felixd/STM32-GPSDO/software/GPSDO/Sensor_BMP180.h

/*
  Sensor_BMP180.h - Library for handling BMP180 sensor
  Created by Paweł 'felixd' Wojciechowski, Janury 31, 2022.

  BMP180 is I2C atmospheric pressure, temperature and altitude sensor
*/

#ifndef GPSDO_SENSOR_BMP180_h
#define GPSDO_SENSOR_BMP180_h

#include <Arduino.h>
#include <Adafruit_BMP085.h>

/*
 * Just to quickly, be able to integrate it with Andrews GPSDO
 */
#define GPSDO_SENSOR_BMP280

#endif
