felixd/STM32-GPSDO/software/GPSDO/Sensor_AHT10.h

/*
  Sensor_AHT10.h - Library for handling AHT10 sensor
  Created by Paweł 'felixd' Wojciechowski, Janury 31, 2022.

  AHT10 is I2C temperature and humidity sensor
*/

#include "Arduino.h"
#include <Adafruit_AHTX0.h>

#ifndef GPSDO_SENSOR_AHT10_h
#define GPSDO_SENSOR_AHT10_h
#define GPSDO_SENSOR_AHT10

/*
  Sensor: AHTX0
  Sensing: temperature, humidity
  Library: Adafruit_AHTX0
*/

#endif
