felixd/STM32-GPSDO/software/GPSDO/Sensor_INA219.cpp

/*
  Sensor_INA219.h - Library for handling INA219 sensor
  Created by Paweł 'felixd' Wojciechowski, Janury 31, 2022.

  INA219 is I2C Power sensor. It measures Current and Voltage
*/

#include "Sensor_INA219.h"
