felixd/STM32-GPSDO/software/GPSDO/Vctl_MCP4725.h

/*
  Vctl_MCP4725.h - Library for handling OCXO Voltage Control using MCP4725 12-bit DAC
  Created by Paweł 'felixd' Wojciechowski, Janury 31, 2022.
*/

#include "Arduino.h"
#include <Adafruit_MCP4725.h>

#ifndef GPSDO_VCTL_MCP4725_h
#define GPSDO_VCTL_MCP4725_h
#define GPSDO_VCTL_MCP4725 

/*
  OCXO Control Voltage
  Two options are support at the moment:
  - 12-bit MCP4725 DAC used iwth Adafruit library
  - 16-bit PWM signal from STM32 μC (preferred)
*/

#endif
