felixd/STM32-GPSDO/(commit log)

2022-01-28 MCP4725 fix (can be turned off now).
    [GPSDO.ino]
2022-01-28 Arduino IDE 1.8 Code Autoformat
2022-01-30 3V3 / 5V naming
2022-02-03 PWM trend regulation (v2) + BMP180
