felixd/STM32-GPSDO/(notices)

Notices in the files:
README.md:
License: GPL v3
License: CC BY-SA 3.0
